Synt4xErr0r4/eeprom_programmer/eeprom_prog.kicad_pcb

## KiCad design eeprom_prog.kicad_pcb (2026-10-29)

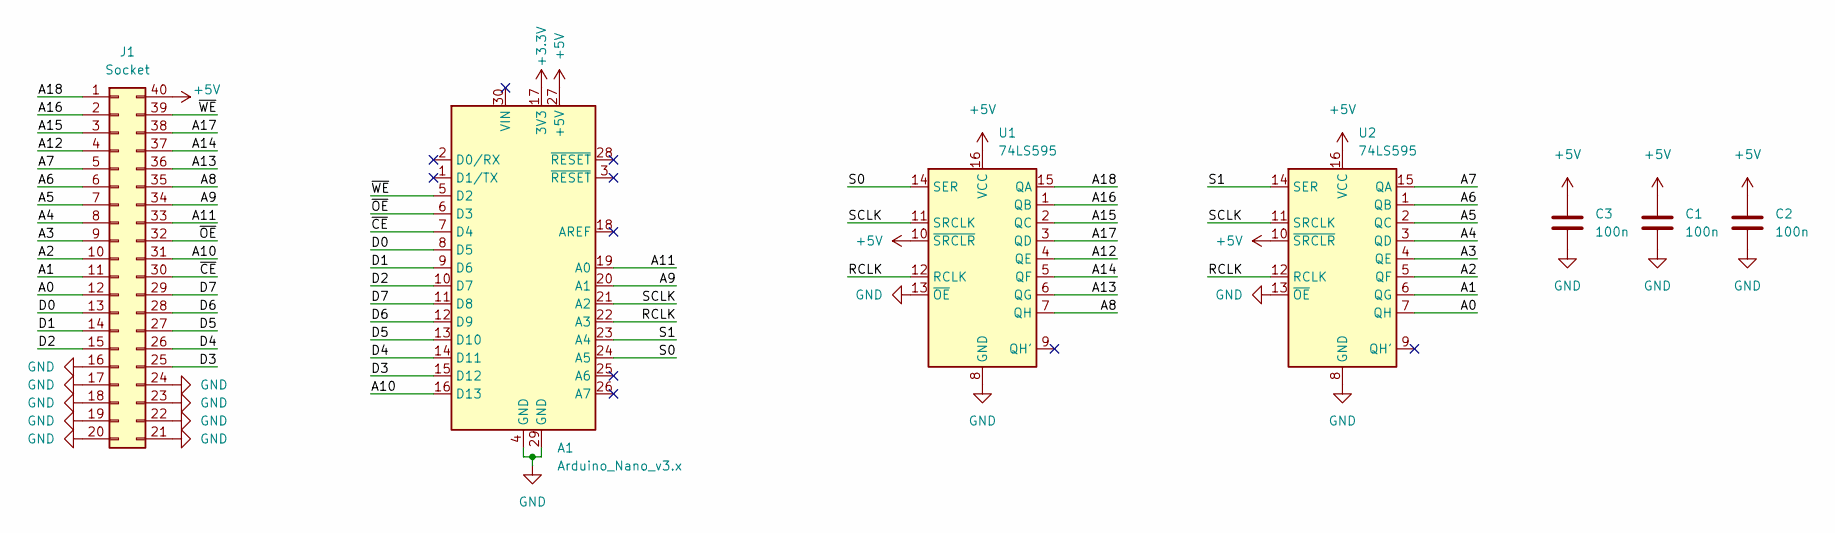
[picture p2: schematic eeprom_prog.kicad_sch]

Parts:
A1: Arduino_Nano_v3.x; Arduino_Nano
C1, C2, C3: 100n; C_Disc_D7.5mm_W5.0mm_P5.00mm
J1: Socket; DIP-40_W15.24mm_Socket_LongPads
U1, U2: 74LS595; DIP-16_W7.62mm_LongPads

Connections:
+3.3V: A1.17 (3V3)
+5V: A1.27 (+5V), C1.1, C2.1, C3.1, J1.40, U1.10 (~SRCLR), U1.16 (VCC), U2.10 (~SRCLR), U2.16 (VCC)
/A0: J1.12, U2.7 (QH)
/A1: J1.11, U2.6 (QG)
/A2: J1.10, U2.5 (QF)
/A3: J1.9, U2.4 (QE)
/A4: J1.8, U2.3 (QD)
/A5: J1.7, U2.2 (QC)
/A6: J1.6, U2.1 (QB)
/A7: J1.5, U2.15 (QA)
/A8: J1.35, U1.7 (QH)
/A9: A1.20 (A1), J1.34
/A10: A1.16 (D13), J1.31
/A11: A1.19 (A0), J1.33
/A12: J1.4, U1.4 (QE)
/A13: J1.36, U1.6 (QG)
/A14: J1.37, U1.5 (QF)
/A15: J1.3, U1.2 (QC)
/A16: J1.2, U1.1 (QB)
/A17: J1.38, U1.3 (QD)
/A18: J1.1, U1.15 (QA)
/D0: A1.8 (D5), J1.13
/D1: A1.9 (D6), J1.14
/D2: A1.10 (D7), J1.15
/D3: A1.15 (D12), J1.25
/D4: A1.14 (D11), J1.26
/D5: A1.13 (D10), J1.27
/D6: A1.12 (D9), J1.28
/D7: A1.11 (D8), J1.29
/RCLK: A1.22 (A3), U1.12 (RCLK), U2.12 (RCLK)
/S0: A1.24 (A5), U1.14 (SER)
/S1: A1.23 (A4), U2.14 (SER)
/SCLK: A1.21 (A2), U1.11 (SRCLK), U2.11 (SRCLK)
/~CE: A1.7 (D4), J1.30
/~OE: A1.6 (D3), J1.32
/~WE: A1.5 (D2), J1.39
GND: A1.4 (GND), A1.29 (GND), C1.2, C2.2, C3.2, J1.16, J1.17, J1.18, J1.19, J1.20, J1.21, J1.22, J1.23, J1.24, U1.8 (GND), U1.13 (~OE), U2.8 (GND), U2.13 (~OE)

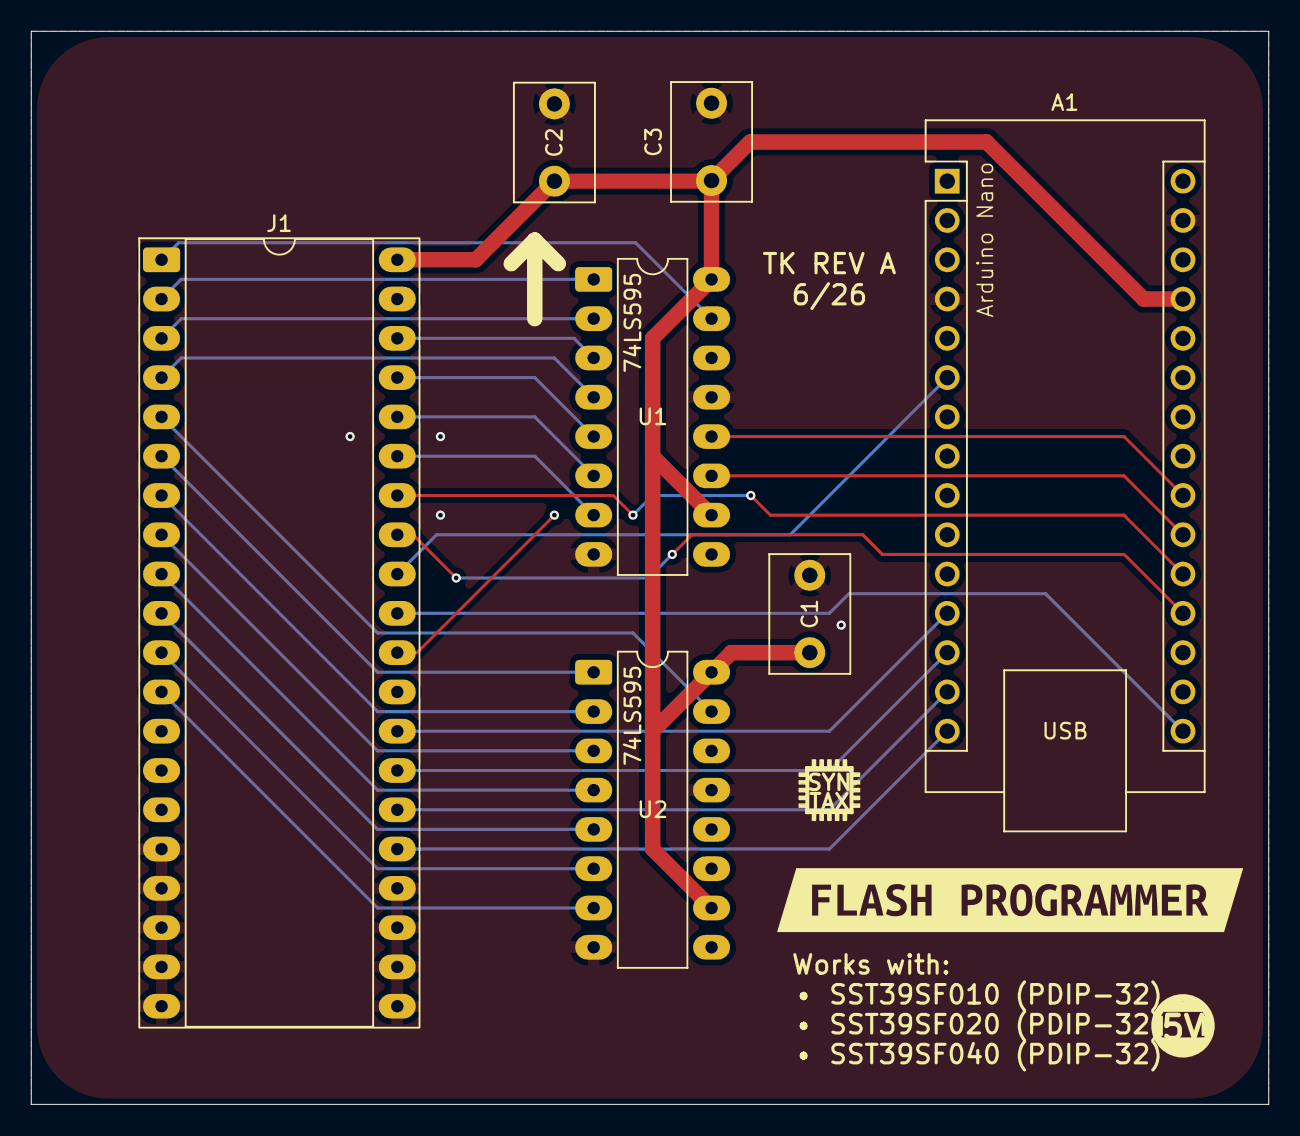
[picture p3: board eeprom_prog.kicad_pcb from above]

Board: 4 copper layers, 80.0 x 69.4 mm, 8 parts (0 on the bottom side), 36 nets.

Other parts of the board:
kibuzzard-6A224154: G***; kibuzzard-6A224154
